digifab-ar/Mate-Point-v1/UI/figma/imagenes/full-image-ad1.png

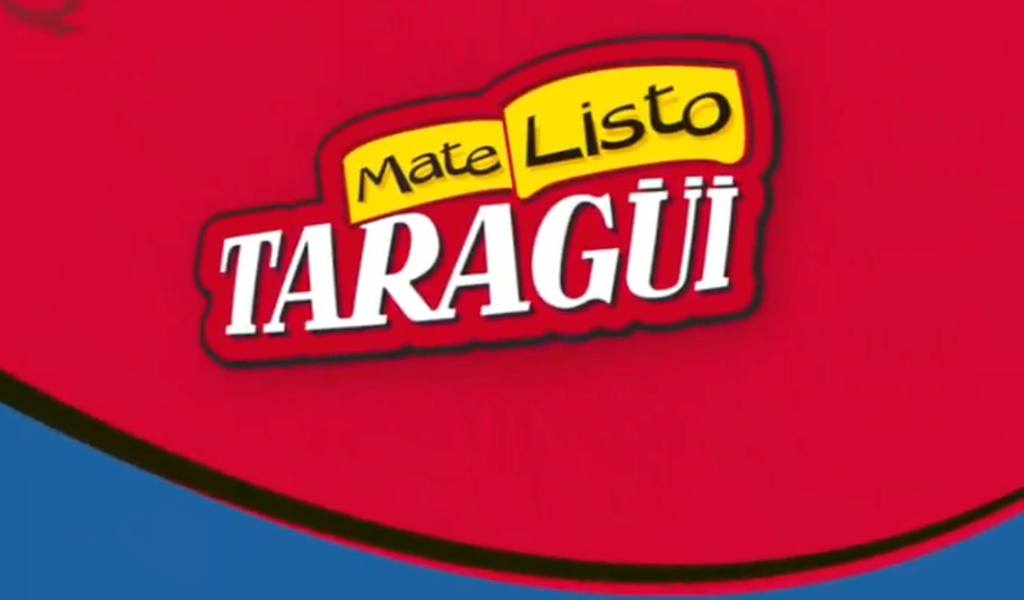
UI/figma/imagenes/full-image-ad1.png
