digifab-ar/Mate-Point-v1/UI/figma/pantallas/Pantalla Standby.png

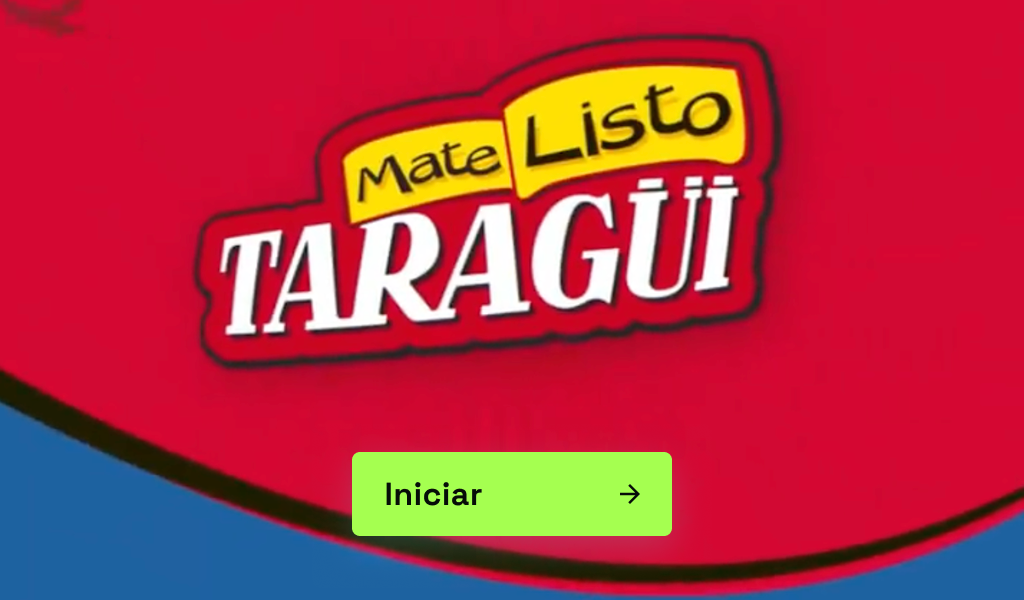
UI/figma/pantallas/Pantalla Standby.png
