digifab-ar/Mate-Point-v1/tools/nobana_uart_sniffer/capturas/2026-06-03-inicio-dispense-coffee-fin.md

# Captura YYYY-MM-DD — título corto

## Metadatos

## Objetivo

Analizar el comportamiento darle ON al nobana (y en su defecto al armor) , selecionar Coffee y que se inicie el dispensado (por defecto está en 180ml) , dejar que haga todo el ciclo de dispensado, y corte solo.

## Resultado observable

- Se prende el modulo armor desbloqeuado mostrando la temperatura 25°C.
- se escucha 2 veces el chime
- se selecciona coffee ( 1 chime) y luego de unos segundos empieza a dispensar
- En la pantalla se muestra 85°C.
- al finalizar se muestra END en la pantalla.
- Al finalizar se escuchar un chime.

## Log UART

13:01:38.456 -> [554546] WARN trunc NOB->ARM len=128 HEX: 00 00 00 00 00 00 00 00 00 00 00 00 00 00 00 00 00 00 00 00 00 00 00 00 00 00 00 00 00 00 00 00 00 00 00 00 00 00 00 00 00 00 00 00 00 00 00 00 00 00 00 00 00 00 00 00 00 00 00 00 00 00 00 00 00 00 00 00 00 00 00 00 00 00 00 00 00 00 00 00 00 00 00 00 00 00 00 00 00 00 00 00 00 00 00 00 00 00 00 00 00 00 00 00 00 00 00 00 00 00 00 00 00 00 00 00 00 00 00 00 00 00 00 00 00 00 00 00
13:01:38.488 -> [554582] FRAME NOB->ARM len=2 HEX: 00 00
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
13:02:35.019 -> [611103] FRAME NOB->ARM len=11 HEX: 68 05 12 3A 15 00 00 00 00 00 CE

## Secuencia inferida (opcional)

| Paso | Dir. | Trama / evento |
|---|---|---|
| 1 | | |
| 2 | | |

## Notas / anomalías

-

## Conclusión preliminar

## Referencias
