digifab-ar/Mate-Point-v1/tools/nobana_uart_sniffer/capturas/2026-06-03-inicio-fin.md

# Captura YYYY-MM-DD — título corto

## Metadatos

## Objetivo

Analizar el comportamiento darle ON al nobana (y en su defecto al armor) , y darle OFF.
## Resultado observable

- Se prende el modulo armor desbloqeuado mostrando la temperatura 25°C.
- se escucha 2 veces el chime

## Log UART

12:55:51.539 -> [207629] WARN trunc NOB->ARM len=128 HEX: 00 00 00 00 00 00 00 00 00 00 00 00 00 00 00 00 00 00 00 00 00 00 00 00 00 00 00 00 00 00 00 00 00 00 00 00 00 00 00 00 00 00 00 00 00 00 00 00 00 00 00 00 00 00 00 00 00 00 00 00 00 00 00 00 00 00 00 00 00 00 00 00 00 00 00 00 00 00 00 00 00 00 00 00 00 00 00 00 00 00 00 00 00 00 00 00 00 00 00 00 00 00 00 00 00 00 00 00 00 00 00 00 00 00 00 00 00 00 00 00 00 00 00 00 00 00 00 00
12:55:51.571 -> [207666] FRAME NOB->ARM len=2 HEX: 00 00
12:55:51.571 -> [207666] FRAME ARM->NOB len=125 HEX: 00 00 00 00 00 00 00 00 00 00 00 00 00 00 00 00 00 00 00 00 00 00 00 00 00 00 00 00 00 00 00 00 00 00 00 00 00 00 00 00 00 00 00 00 00 00 00 00 00 00 00 00 00 00 00 00 00 00 00 00 00 00 00 00 00 00 00 00 00 00 00 00 00 00 00 00 00 00 00 00 00 00 00 00 00 00 00 00 00 00 00 00 00 00 00 00 00 00 00 00 00 00 00 00 00 00 00 00 00 00 00 00 00 00 00 00 00 00 00 00 00 00 00 00 00
12:55:51.868 -> [207968] FRAME ARM->NOB len=14 HEX: 00 00 00 00 00 00 00 00 00 00 00 00 00 00
12:55:51.901 -> [207992] FRAME NOB->ARM len=15 HEX: 00 00 00 00 00 00 00 00 00 00 00 00 00 00 00
12:55:52.070 -> [208161] FRAME ARM->NOB len=1 HEX: F8
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
12:56:10.579 -> [226664] FRAME ARM->NOB len=4 HEX: 00 00 00 00

## Secuencia inferida (opcional)

| Paso | Dir. | Trama / evento |
|---|---|---|
| 1 | | |
| 2 | | |

## Notas / anomalías

-

## Conclusión preliminar

## Referencias
