digifab-ar/Mate-Point-v1/mate_point_firmware/PLAN-MATE-POINT-v0-6.md

# Plan de implementación — Mate Point v0-6

**Proyecto:** Mate Point — OT-00268 Etapa 3  
**Carpeta:** [`mate_point_v0-6/`](mate_point_v0-6/) — fork de [`mate_point_v0-5-2/`](mate_point_v0-5-2/)  
**Base validada:** v0-5-2 (pausa/reanudar Cargar termo + bandeja + agua UART + UI Figma)  
**Plataforma:** Waveshare ESP32-S3-Touch-LCD-7B + Nobana UART + VL53L0X (I2C) + sensor bandeja (GPIO6)  
**Última actualización:** 2026-06-25
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
