digifab-ar/Mate-Point-v1/docs/hardware/sensor-bandeja-reed-gpio6.png

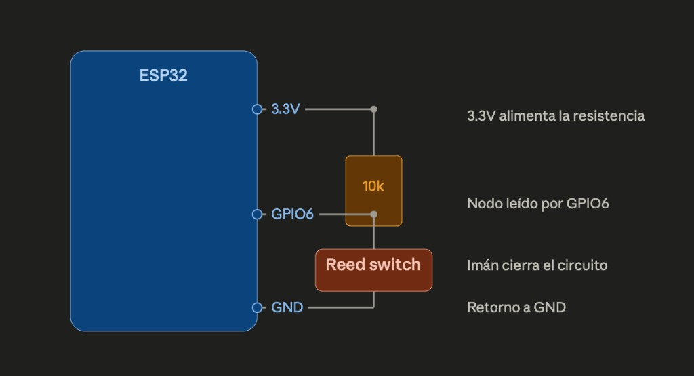
docs/hardware/sensor-bandeja-reed-gpio6.png
