digifab-ar/Mate-Point-v1/UI/figma/imagenes/Split-image-Ad1.png

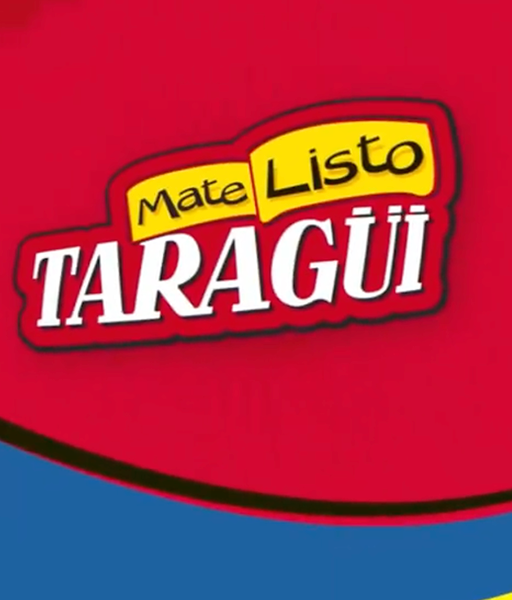
UI/figma/imagenes/Split-image-Ad1.png
