digifab-ar/Mate-Point-v1/UI/figma/imagenes/Split-image-agua.png

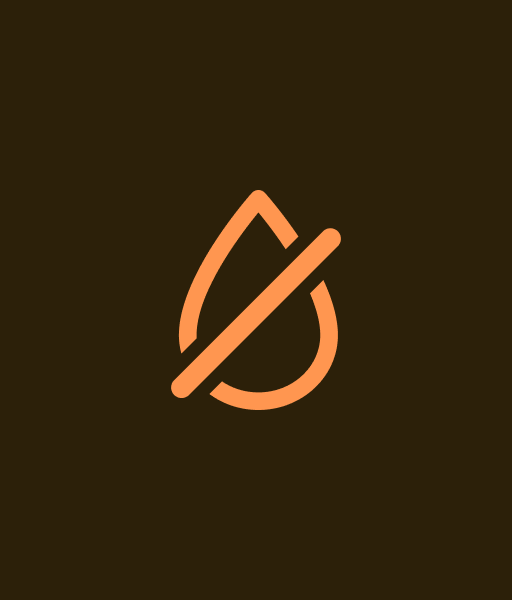
UI/figma/imagenes/Split-image-agua.png
