digifab-ar/Mate-Point-v1/UI/figma/imagenes/Split-image-coloca-termo.png

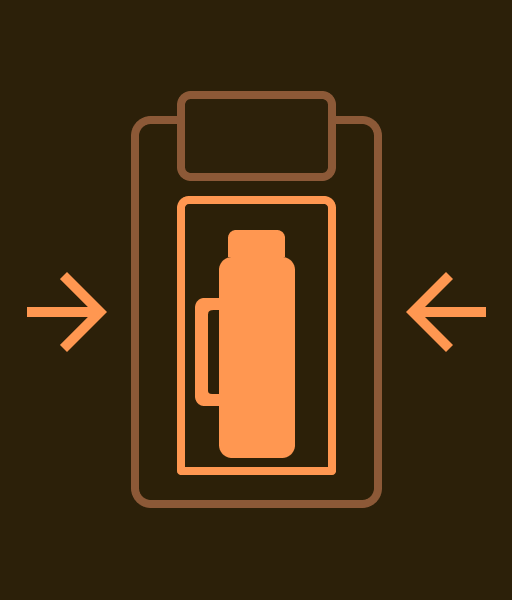
UI/figma/imagenes/Split-image-coloca-termo.png
