digifab-ar/Mate-Point-v1/UI/figma/imagenes/Split-image-error-pago.png

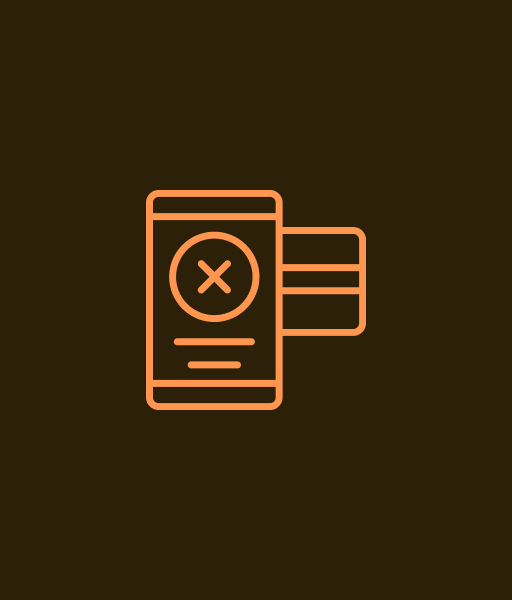
UI/figma/imagenes/Split-image-error-pago.png
