digifab-ar/Mate-Point-v1/UI/figma/imagenes/Split-image-error-wifi-mqtt.png

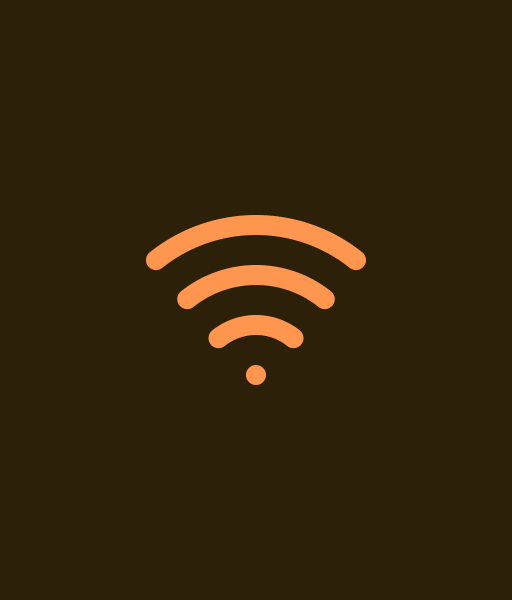
UI/figma/imagenes/Split-image-error-wifi-mqtt.png
