digifab-ar/Mate-Point-v1/UI/figma/imagenes/Split-image-QR.png

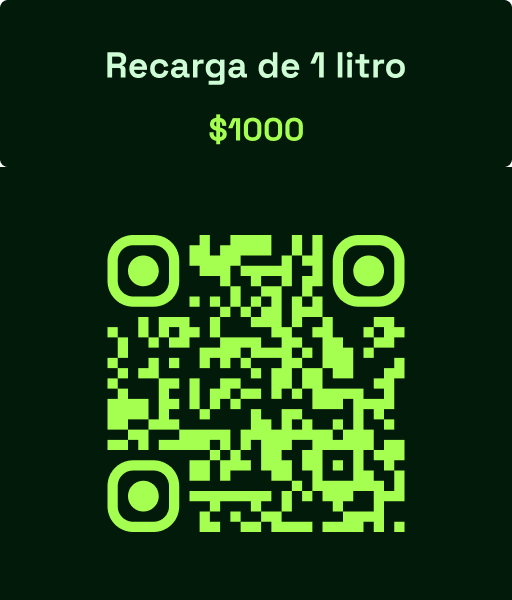
UI/figma/imagenes/Split-image-QR.png
