digifab-ar/Mate-Point-v1/UI/figma/layout/Layout-background-standby.png

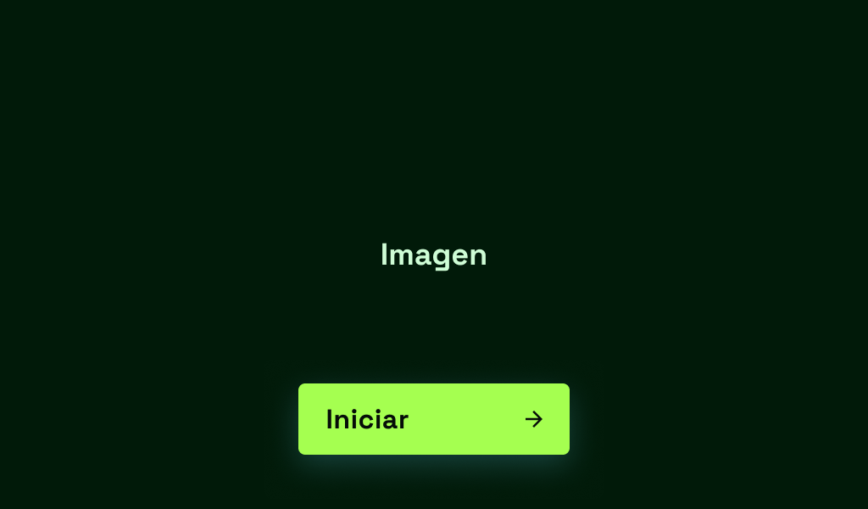
UI/figma/layout/Layout-background-standby.png
