digifab-ar/Mate-Point-v1/UI/figma/layout/Layout-background.png

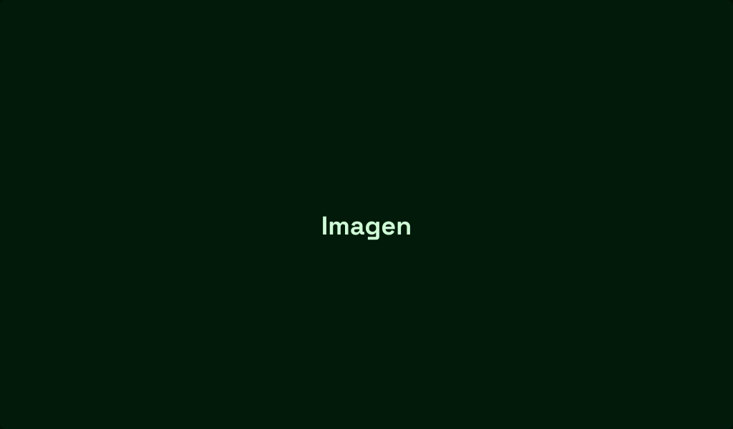
UI/figma/layout/Layout-background.png
