digifab-ar/Mate-Point-v1/UI/figma/layout/Layout-split.png

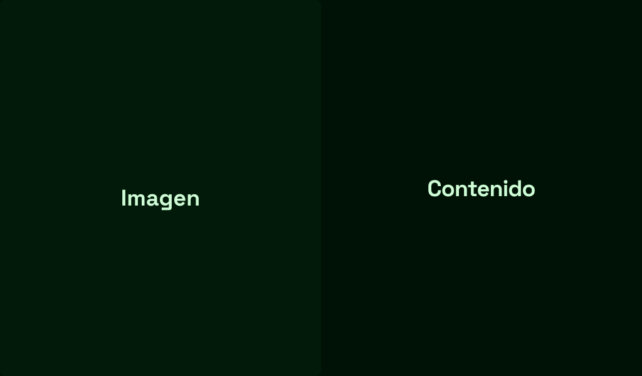
UI/figma/layout/Layout-split.png
