digifab-ar/Mate-Point-v1/UI/figma/pantallas/Cargar-termo-dispensing.png

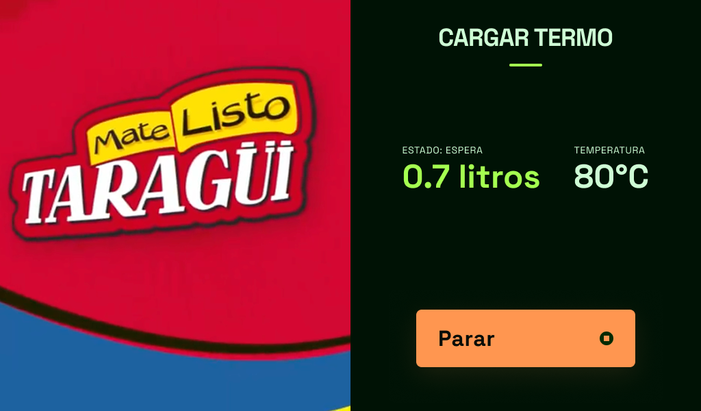
UI/figma/pantallas/Cargar-termo-dispensing.png
