digifab-ar/Mate-Point-v1/UI/figma/pantallas/Cargar-termo-pause.png

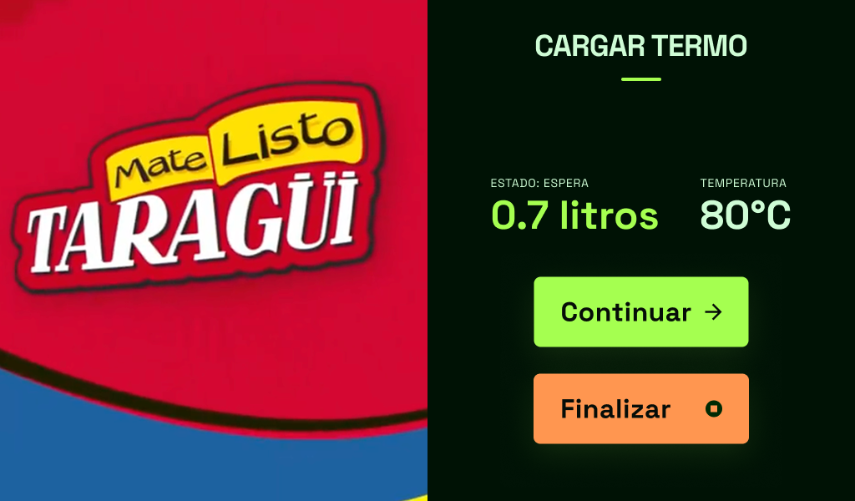
UI/figma/pantallas/Cargar-termo-pause.png
