digifab-ar/Mate-Point-v1/UI/figma/pantallas/Coloca-termo.png

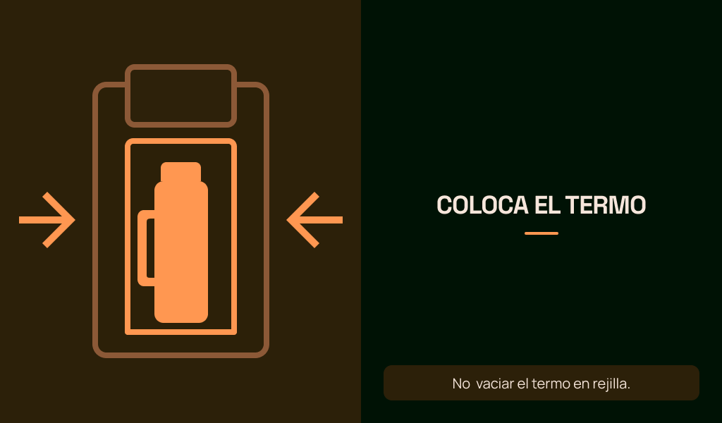
UI/figma/pantallas/Coloca-termo.png
