digifab-ar/Mate-Point-v1/UI/figma/pantallas/Configurar red.png

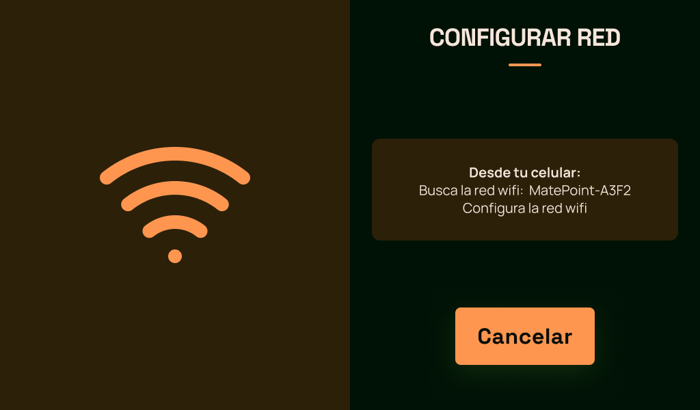
UI/figma/pantallas/Configurar red.png
