digifab-ar/Mate-Point-v1/UI/figma/pantallas/error-agua-desconectada.png

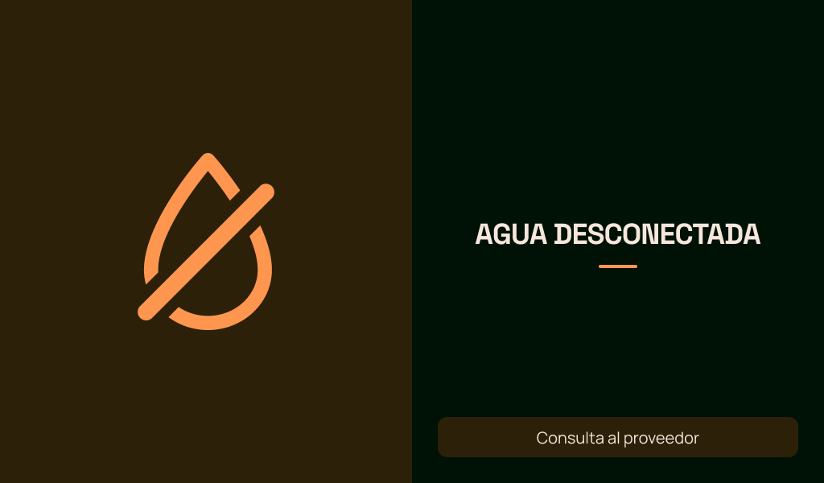
UI/figma/pantallas/error-agua-desconectada.png
