digifab-ar/Mate-Point-v1/UI/figma/pantallas/Error-pago.png

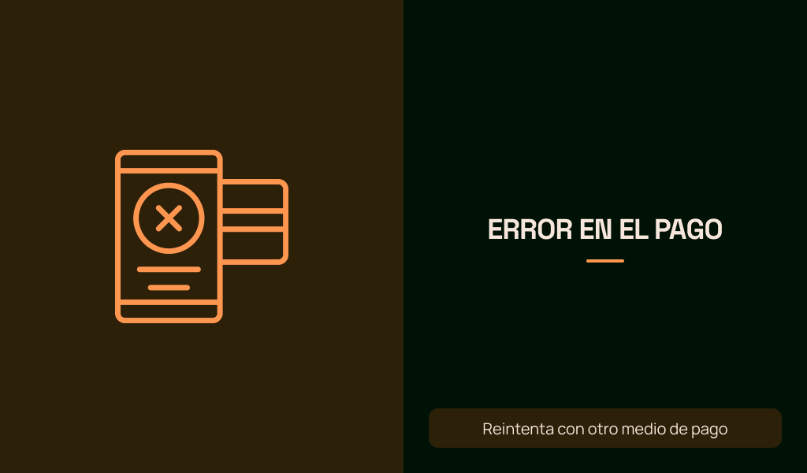
UI/figma/pantallas/Error-pago.png
