digifab-ar/Mate-Point-v1/UI/figma/pantallas/Error-wifi.png

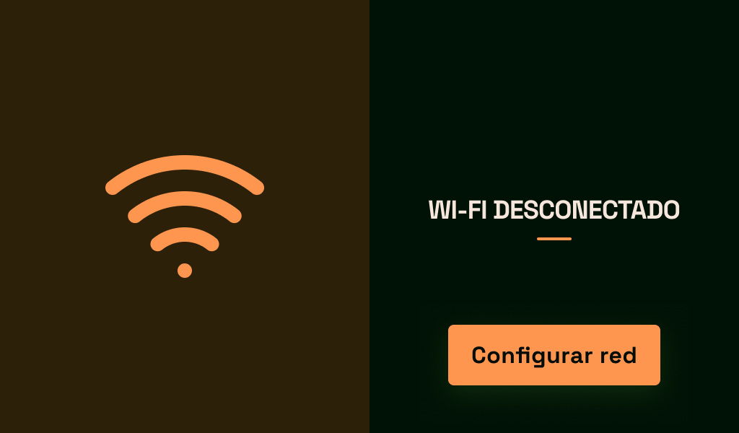
UI/figma/pantallas/Error-wifi.png
