digifab-ar/Mate-Point-v1/UI/figma/pantallas/Pago-QR.png

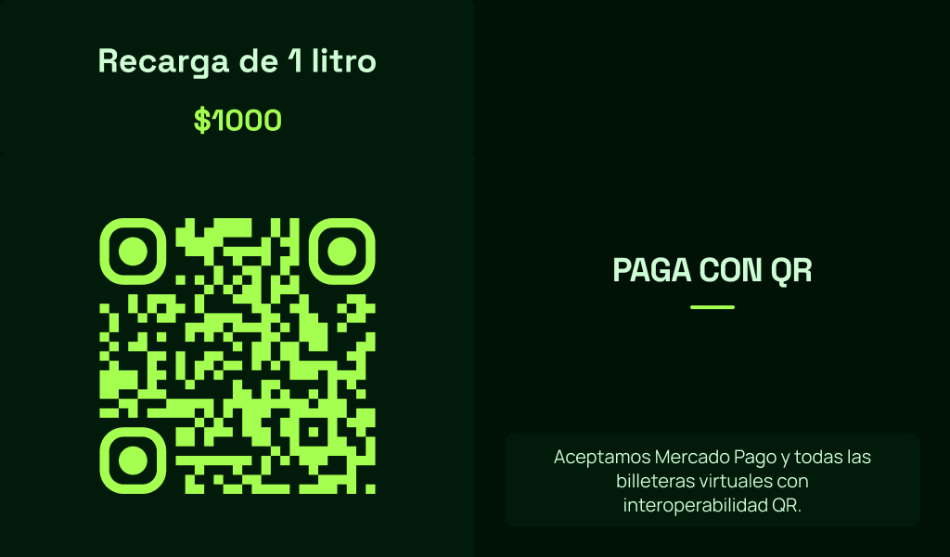
UI/figma/pantallas/Pago-QR.png
