digifab-ar/Mate-Point-v1/UI/figma/secciones/Split-Contenido_Titulo+card-1.png

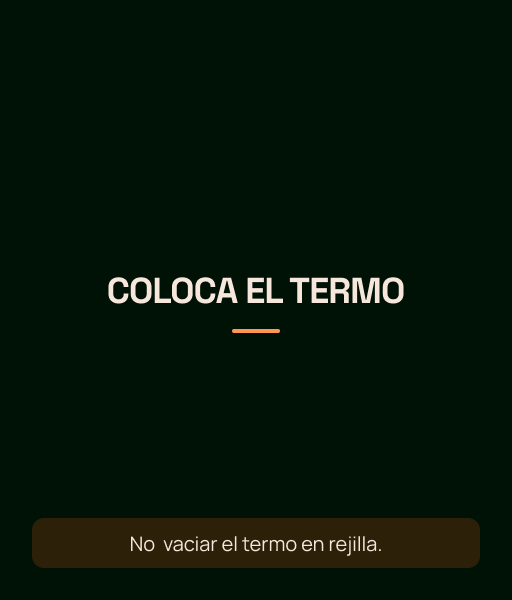
UI/figma/secciones/Split-Contenido_Titulo+card-1.png
