digifab-ar/Mate-Point-v1/UI/figma/secciones/Split-Contenido_Titulo+card.png

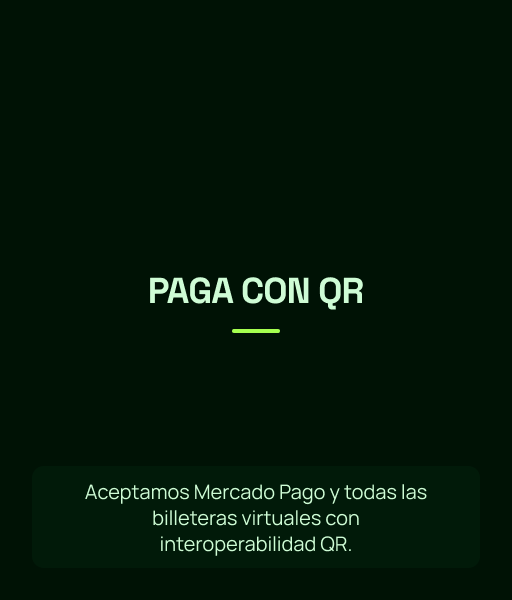
UI/figma/secciones/Split-Contenido_Titulo+card.png
