digifab-ar/Mate-Point-v1/UI/figma/secciones/Split-Contenido_Titulo+content+CTA-1.png

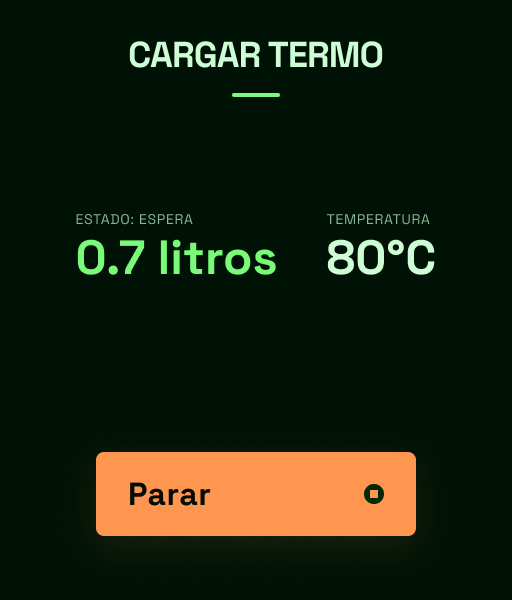
UI/figma/secciones/Split-Contenido_Titulo+content+CTA-1.png
