digifab-ar/Mate-Point-v1/tools/nobana_uart_sniffer/capturas/2026-06-03-inicio-dispense-coffee-fin_manual.md

# Captura YYYY-MM-DD — título corto

## Metadatos

## Objetivo

Analizar el comportamiento darle ON al nobana (y en su defecto al armor) , selecionar Coffee y que se inicie el dispensado (por defecto está en 180ml) , cortar el dispensado medinate el boton coffee, y esperar a que se bloquee.

## Resultado observable

- Se prende el modulo armor desbloqeuado mostrando la temperatura 25°C.
- se escucha 2 veces el chime
- se selecciona coffee ( 1 chime) y luego de unos segundos empieza a dispensar
- En la pantalla se muestra 85°C.
- Se detiene el dispensado luego de 3 segundo aprox desde que apreto el boton coffee para detenerlo (1 chime).
- al finalizar se muestra END en la pantalla.
- Al finalizar se escuchar un chime.
- se bloquea.

## Log UART

17:37:51.206 -> [20964] FRAME ARM->NOB len=126 HEX: 00 00 00 00 00 00 00 00 00 00 00 00 00 00 00 00 00 00 00 00 00 00 00 00 00 00 00 00 00 00 00 00 00 00 00 00 00 00 00 00 00 00 00 00 00 00 00 00 00 00 00 00 00 00 00 00 00 00 00 00 00 00 00 00 00 00 00 00 00 00 00 00 00 00 00 00 00 00 00 00 00 00 00 00 00 00 00 00 00 00 00 00 00 00 00 00 00 00 00 00 00 00 00 00 00 00 00 00 00 00 00 00 00 00 00 00 00 00 00 00 00 00 00 00 00 00
17:37:52.953 -> [22728] FRAME ARM->NOB len=87 HEX: 00 00 00 00 00 00 00 00 00 00 00 00 00 00 00 00 00 00 00 00 00 00 00 00 00 00 00 00 00 00 00 00 00 00 00 00 00 00 00 00 00 00 00 00 00 00 00 00 00 00 00 00 00 00 00 00 00 00 00 00 00 00 00 00 00 00 00 00 00 00 00 00 00 00 00 00 00 00 00 00 00 00 00 00 00 00 00
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
17:38:30.299 -> [60071] FRAME NOB->ARM len=11 HEX: 68 06 12 49 14 00 00 00 00 00 DD

## Secuencia inferida (opcional)

| Paso | Dir. | Trama / evento |
|---|---|---|
| 1 | | |
| 2 | | |

## Notas / anomalías

-

## Conclusión preliminar

## Referencias
