digifab-ar/Mate-Point-v1/mate_point_firmware/mate_point_v0-8/dispense_controller.h

#pragma once

#include <stdint.h>

enum DispenseEvent {
    DISPENSE_EVENT_NONE,
    DISPENSE_EVENT_IDLE,
    DISPENSE_EVENT_POST_PAY_TIMEOUT,
};

const char *dispense_mqtt_state();
const char *dispense_active_order_id();

bool dispense_cycle_active();
bool dispense_can_accept_comprar();
bool dispense_on_command(const char *order_id, uint32_t duration_ms,
                         uint32_t pause_timeout_ms);
bool dispense_on_iniciar_pressed();
void dispense_on_parar_pressed();
bool dispense_on_continuar_pressed();
void dispense_on_finalizar_pressed();
void dispense_on_tray_full();
void dispense_on_tank_empty();
DispenseEvent dispense_tick();

/** Nueva compra: permite otro order_id (llamar al volver a Comprar). */
void dispense_reset_session();
