digifab-ar/Mate-Point-v1/mate_point_firmware/mate_point_v0-8/ui/ui_assets.h

#pragma once

#include "lvgl.h"

extern const lv_img_dsc_t img_full_image_ad1;
extern const lv_img_dsc_t img_split_image_ad1;
extern const lv_img_dsc_t img_split_image_coloca_termo;
extern const lv_img_dsc_t img_split_image_retira_termo;
extern const lv_img_dsc_t img_split_image_error_pago;
extern const lv_img_dsc_t img_split_image_error_wifi_mqtt;
extern const lv_img_dsc_t img_split_image_agua;
