digifab-ar/Mate-Point-v1/mate_point_firmware/mate_point_v0-8/ui_assets_bundle.c

/*
 * Arduino IDE solo compila .c/.cpp en la raíz del sketch (no subcarpetas).
 * Este archivo incluye todos los assets LVGL generados.
 */
#include "ui/ui_assets/img_full_image_ad1.c"
#include "ui/ui_assets/img_split_image_ad1.c"
#include "ui/ui_assets/img_split_image_coloca_termo.c"
#include "ui/ui_assets/img_split_image_retira_termo.c"
#include "ui/ui_assets/img_split_image_error_pago.c"
#include "ui/ui_assets/img_split_image_error_wifi_mqtt.c"
#include "ui/ui_assets/img_split_image_agua.c"
#ifndef LV_LVGL_H_INCLUDE_SIMPLE
#define LV_LVGL_H_INCLUDE_SIMPLE
#endif
#include "ui/fonts/lv_font_montserrat_bold_32.c"
