digifab-ar/Mate-Point-v1/(commit log)

2026-05-27 Initial commit: docs Mate Point + servidor scaffold para Railway.
    Incluye documentación de integración MP (QR estático), plan de fases,
    arquitectura hardware y backend Node.js en servidor/ listo para Fase 3.
2026-05-27 Documentar avance Fase 3: webhook MP validado en Railway.
    Actualiza estado de implementación, webhooks, MQTT y criterios de aceptación tras prueba e2e sandbox (orden ORDTST01KSNCYH61MNGYP5Q27G0Y5RJD).
2026-05-27 Documentar Fase 3 cerrada y configuración Wi-Fi por USB.
    Actualiza estado e2e (orden ORDTST01KSNFEN3H3FTHXMK9Q1ZPE5NZ), arquitectura Wi-Fi/NVS por monitor serie y planes de implementación.
2026-05-29 Implementar POC v0.2 y endpoints de órdenes MP para flujo Comprar→QR.
    Agrega firmware mate_point_v0-2 con máquina de estados, HTTP a Railway, imagen QR LVGL 8, y POST /orders/create y /orders/cancel en el servidor con expiración PT2M.
2026-05-29 Documentar POC v0.2 implementada y validar E2E en hardware.
    Actualiza docs de estado, endpoints y QR PROGMEM; incluye fix de compilación en display_ui.h.
    [display_ui.h]
2026-06-04 POC UART Nobana: protocolo, firmware Etapa 1 y sniffer; cerrar docs E2E v0.2.
    Documenta el relevamiento del bus, el plan de integración en dos etapas,
    el sketch mate_point_UART_v0-1 y la herramienta de captura; actualiza los
    planes generales tras la validación hardware de Comprar→QR→pago.
2026-06-04 Cerrar Etapa 1 POC UART Nobana: wake manual W, validación banco 2026-06-04.
    Firmware sin wake al arranque; documentar seq por fase, chimes §7.7
    y capturas ESP comparadas con la referencia ARMOR.
2026-06-04 Documentar sensor de tanque Nobana (§4.4) y POC UART kiosco v0-2.
    Captura water-empty valida b2/byte7; firmware W/S/R sin lock final.
2026-06-05 Cerrar POC UART Waveshare v0-3: ciclo auto validado en banco.
    Firmware mate_point_UART_v0-3 (GPIO 44/43), capturas y actualización de
    planes, protocolo y pines sniffer (GPIO25/17).
2026-06-05 Producto mate_point v0-3: UART Nobana E2E, UI Parar y duration_ms 30s.
    Firmware Waveshare v0-3-1 (timer MQTT OK banco), v0-3-2 (UI dispensado) y v0-3-3 (Parar 200 ms OK); plan y capturas sniffer; servidor MQTT pasa a 30 s de dispensado.
2026-06-10 Cerrar Test1 E2E v0-3-3: fin natural timer y 2.ª compra tras Parar.
    Actualizar planes, README y captura sniffer con validación completa en banco Nobana.
2026-07-01 Firmware v0-3-4 a v0-6: UI Figma, sensores, pausa y provisioning Wi-Fi.
    Incluye assets Figma, planes de implementación, arquitectura actualizada,
    capturas UART de banco y herramienta png2lvgl para el producto actual
    (mate_point_v0-6 con NVS + SoftAP + portal web validado en hardware).
    [partitions.csv]
2026-09-08 Publicar oferta y pause_timeout_ms en el servidor para Mate Point v0-9.
    El create y el MQTT llevan nombre/precio y el timer de pausa sin reflash; el firmware v0-9 (base VL6180 v0-7) alinea litros, piso 80 °C y el retiro de termo con esa oferta.
    [partitions.csv]
2026-09-17 Implementar Mate Point v0-8: flota de 4 device_id y ruteo MP/MQTT por caja.
    El servidor deja de usar un POS único y publica dispense en mate/{device_id}/command. Incluye el fork firmware desde v0-9 y el script de alta de sucursal MATEPOINT.
    [partitions.csv]
